IdleHandsProject/youtubeplaybutton/README.md

# youtubeplaybutton
An Arduino YouTube Play Button
