IdleHandsProject/youtubeplaybutton/Outline_Model_150mm_Imported_Details.dxf

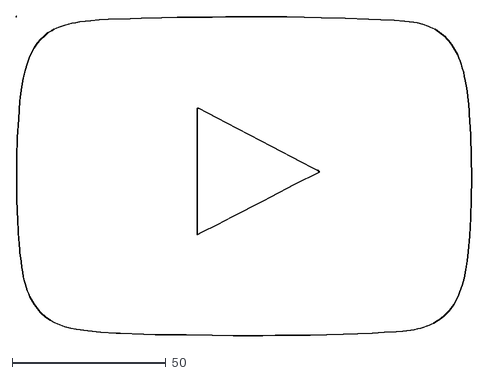
[picture p1: CAD file, 2016-11-22]
Outline_Model_150mm_Imported_Details.dxf
148.2 x 104.1
