IdleHandsProject/youtubeplaybutton/Outline_Model_150mm_Model.dxf

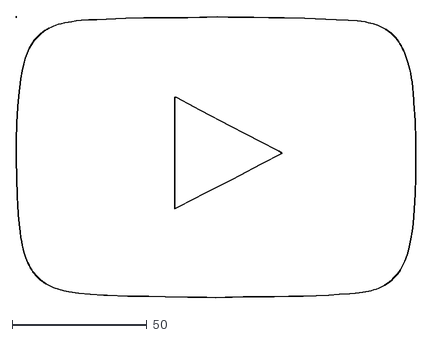
[picture p2: CAD file, 2016-11-22]
Outline_Model_150mm_Model.dxf
148.2 x 104.1
