IdleHandsProject/youtubeplaybutton/Outline_Model.dxf

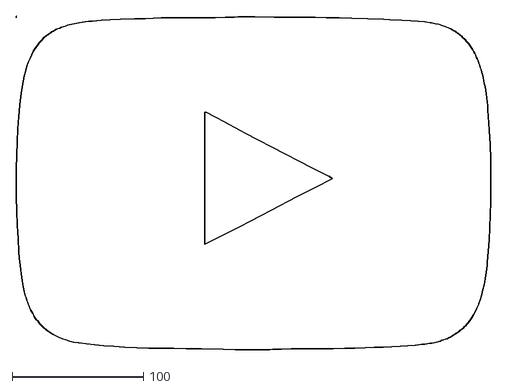
[picture p3: CAD file, 2016-11-22]
Outline_Model.dxf
361.4 x 254.0
