IdleHandsProject/youtubeplaybutton/Outline_Imported_Details.dxf

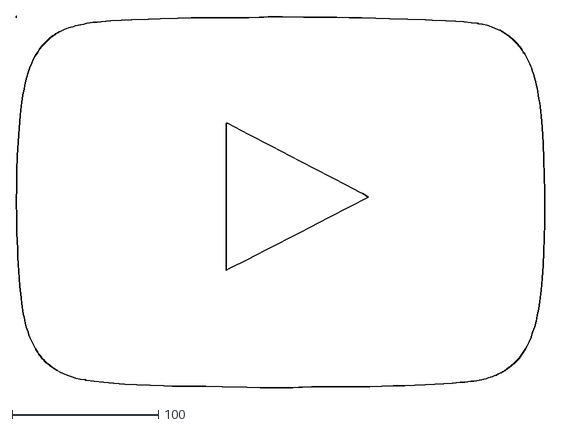
[picture p4: CAD file, 2016-11-22]
Outline_Imported_Details.dxf
361.4 x 254.0
