IdleHandsProject/youtubeplaybutton/playbutton.kicad_pcb

## KiCad design playbutton.kicad_pcb (2016-11-25)

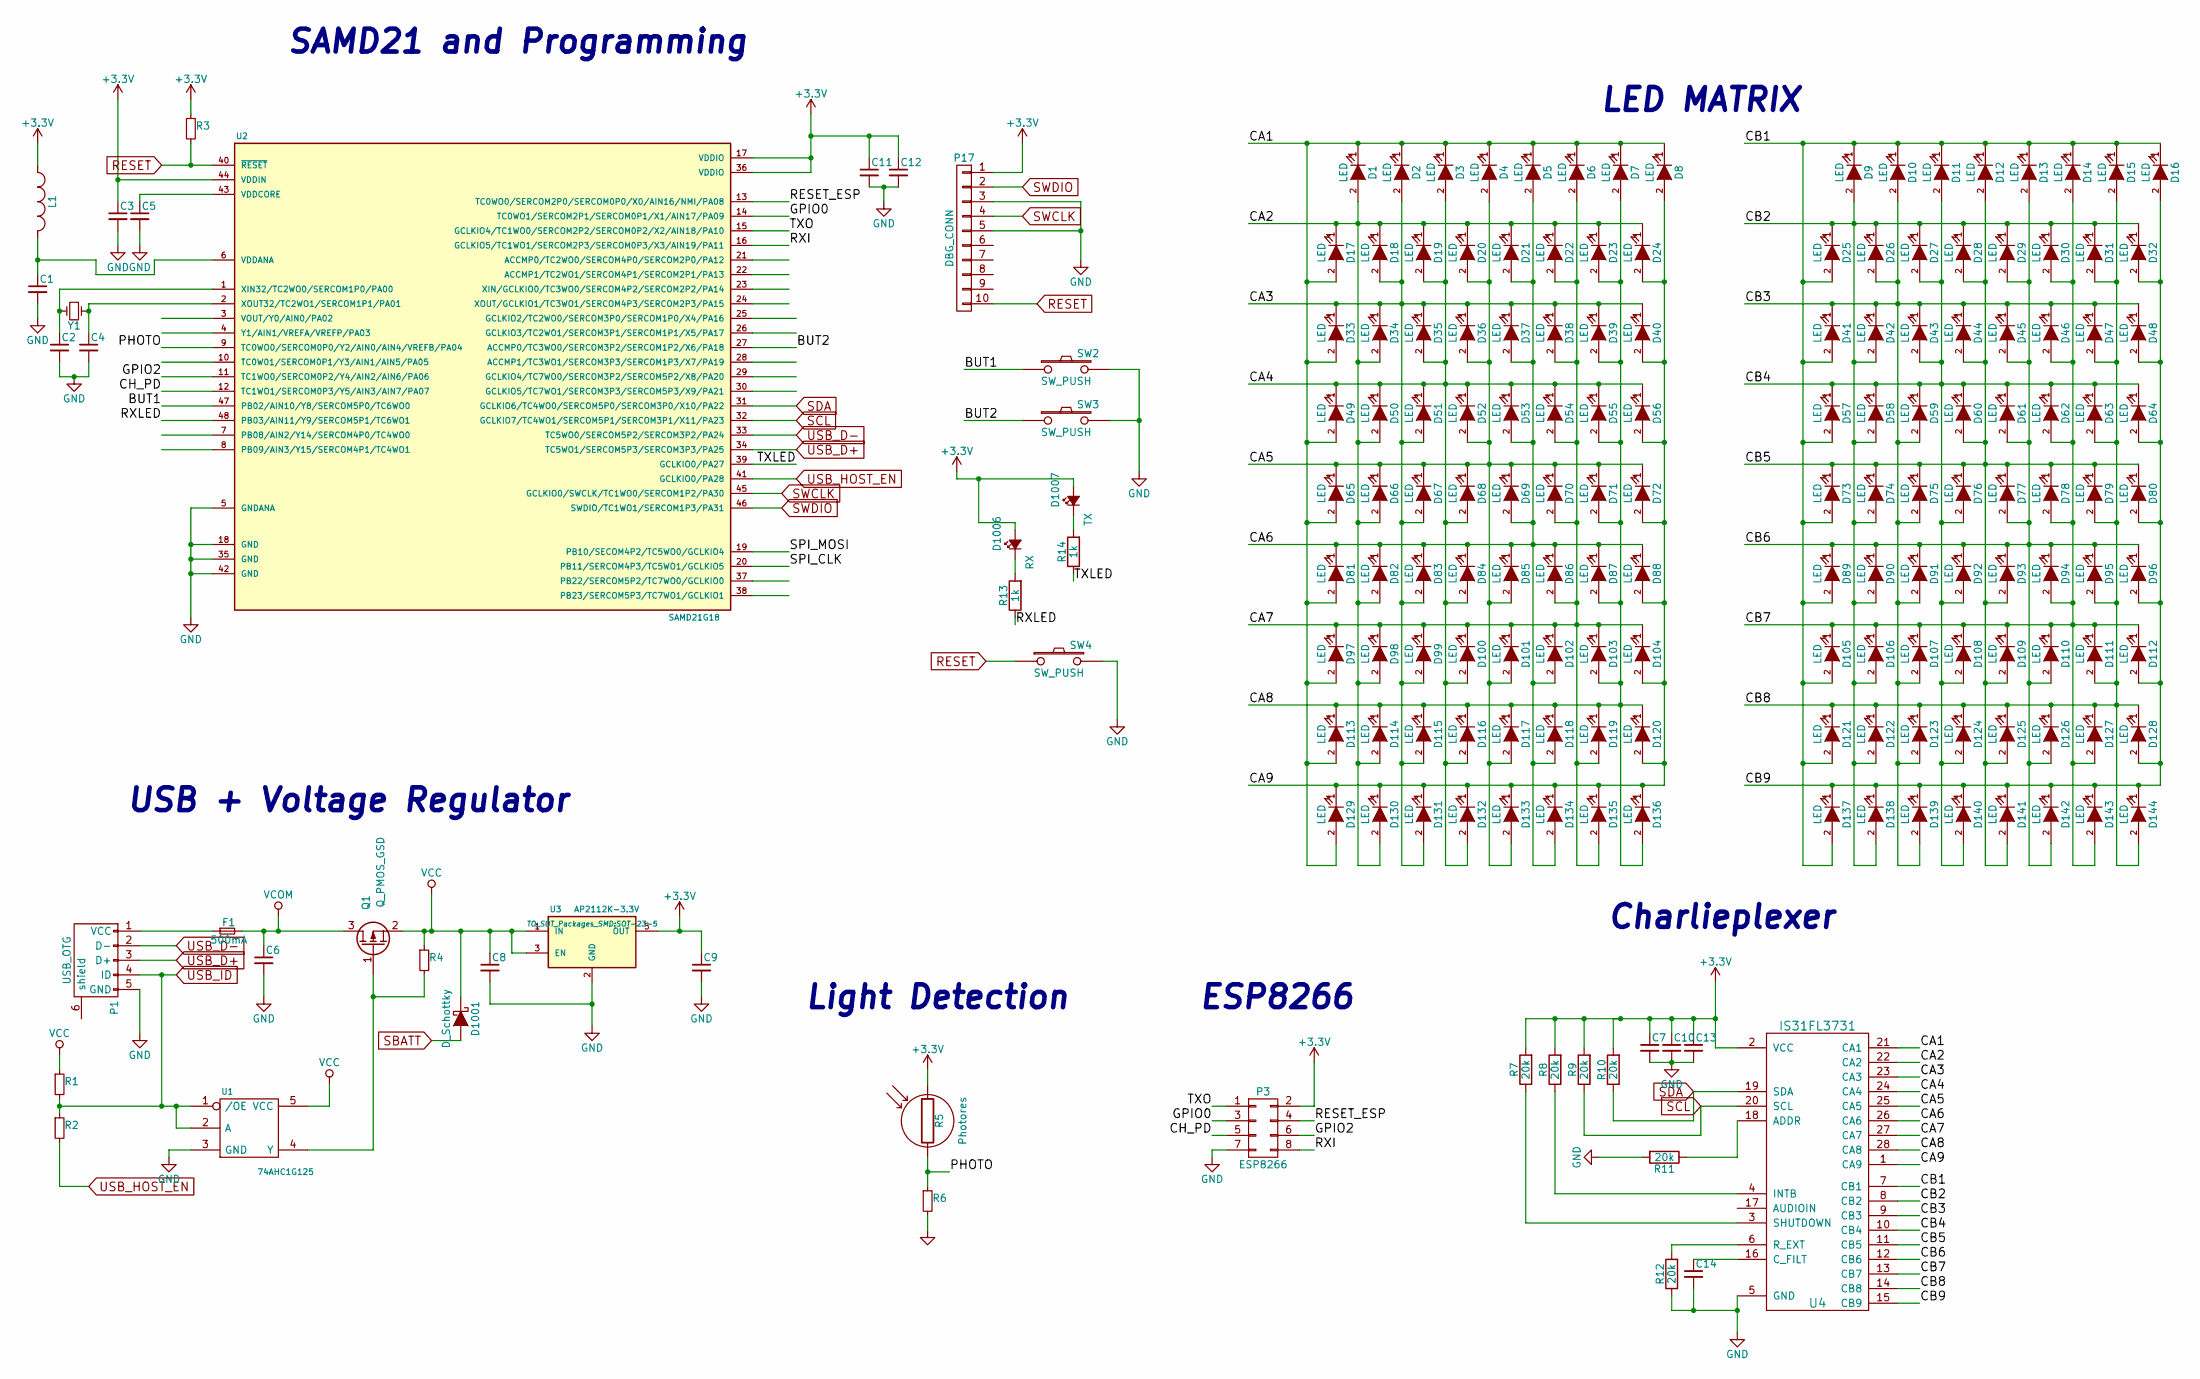
[picture p5: schematic playbutton.sch]

Parts:
C1, C3, C5, C11, C12, C13, C14: 0.1uF; C_0402_Hand; Digikey Part No. 490-6328-1-ND
C2, C4: 15pF; C_0402_Hand; Digikey Part No. 712-1261-1-ND
C6: 2.2uF; c_1206; Digikey Part No. 1276-1291-1-ND
C7, C10: 10uF; C_SM0603; Digikey Part No. 490-6405-1-ND
C8: 1uF; C_0402_Hand; Digikey Part No. 490-4516-1-ND
C9: 2.2uF; C_0402_Hand; Digikey Part No. 587-1059-1-ND
D1, D2, D3, D4, D5, D6, D7, D8, D9, D10, D11, D12, D13, D14, D15, D16, D17, D18, D19, D20, D21, D22, D23, D24, D25, D26, D27, D28, D29, D30, D31, D32, D33, D34, D35, D36, D37, D38, D39, D40, D41, D42, D43, D44, D45, D46, D47, D48, D49, D50, D51, D52, D53, D54, D55, D56, D57, D58, D59, D60, D61, D62, D63, D64, D65, D66, D67, D68, D69, D70, D71, D72, D73, D74, D75, D76, D77, D78, D79, D80, D81, D82, D83, D84, D85, D86, D87, D88, D89, D90, D91, D92, D93, D94, D95, D96, D97, D98, D99, D100, D101, D102, D103, D104, D105, D106, D107, D108, D109, D110, D111, D112, D113, D114, D115, D116, D117, D118, D119, D120, D121, D122, D123, D124, D125, D126, D127, D128, D129, D130, D131, D132, D133, D134, D135, D136, D137, D138, D139, D140, D141, D142, D143, D144: LED; Led_0603
D1001: D_Schottky; sod80c
D1006: RX; Led_0603; Digikey Part No. 160-1447-1-ND
D1007: TX; Led_0603; Digikey Part No. 160-1448-1-ND
F1: 500mA; c_1206; Digikey Part No. 507-1803-1-ND
L1: FB - 30Ohm; R_SM0603; Digikey Part No. 445-2986-1-ND
P1: USB_OTG; USB_Micro-B; Digikey Part No. 609-4618-1-ND
P3: ESP8266; Pin_Header_Straight_2x04
P17: DBG_CONN; Pin_Header_Straight_2x05_Pitch1.27mm; Digikey Part No. 1175-1627-ND
Q1: Q_PMOS_GSD; SOT23
R1: 100k; R_0402_Hand; Digikey Part No. 311-100KLRCT-ND
R2: 330; R_0402_Hand; Digikey Part No. 311-330JRCT-ND
R3, R6: 10k; R_0402_Hand; Digikey Part No. 311-10KJRCT-ND
R4: 47K; R_0402_Hand; Digikey Part No. 311-47.0KLRCT-ND
R5: Photores; Pin_Header_Straight_1x02
R7, R8, R9, R10, R11, R12: 20k; R_0402_Hand; Digikey Part No. 311-20KJRCT-ND
R13, R14: 1k; R_0402_Hand; Digikey Part No. 311-1.0KJRCT-ND
SW2: SW_PUSH; SW_SPST_PTS645; Digikey Part No. CKN9112CT-ND
SW3: SW_PUSH; SW_SPST_PTS645; Digikey Part No. CKN9084CT-ND
SW4: SW_PUSH; SW_SPST_EVQPE1; Digikey Part No. CKN9084CT-ND
U1: 74AHC1G125; sot23-5; Digikey Part No. 568-4452-1-ND
U2: SAMD21G18; TQFP-48_7x7mm_Pitch0.5mm; Digikey Part No. ATSAMD21G18A-AU-ND
U3: AP2112K-3.3V; SOT-23-5; Digikey Part No. AP2112K-3.3TRG1DICT-ND
U4: IS31FL3731; QFN-28-1EP_4x4mm_Pitch0.4mm
Y1: Crystal_Small; crystal_smd_5x3.2mm; Digikey Part No. 535-9536-1-ND

Connections:
+3V3: C3.1, C7.1, C9.1, C10.1, C11.1, C12.1, C13.1, D1006.2 (A), D1007.2 (A), L1.1, P3.2, P17.1, R3.1, R5.1, R7.2, R8.2, R9.2, R10.2, U2.17 (VDDIO), U2.36 (VDDIO), U2.44 (VDDIN), U3.5 (OUT), U4.2 (VCC)
/BUT1: SW2.1, U2.47 (PB02/AIN10/Y8/SERCOM5P0/TC6WO0)
/BUT2: SW3.1, U2.27 (ACCMP0/TC3WO0/SERCOM3P2/SERCOM1P2/X6/PA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)
/CA1: D1.1 (K), D2.1 (K), D3.1 (K), D4.1 (K), D5.1 (K), D6.1 (K), D7.1 (K), D8.1 (K), D17.2 (A), D33.2 (A), D49.2 (A), D65.2 (A), D81.2 (A), D97.2 (A), D113.2 (A), D129.2 (A), U4.21 (CA1)
/CA2: D1.2 (A), D17.1 (K), D18.1 (K), D19.1 (K), D20.1 (K), D21.1 (K), D22.1 (K), D23.1 (K), D24.1 (K), D34.2 (A), D50.2 (A), D66.2 (A), D82.2 (A), D98.2 (A), D114.2 (A), D130.2 (A), U4.22 (CA2)
/CA3: D2.2 (A), D18.2 (A), D33.1 (K), D34.1 (K), D35.1 (K), D36.1 (K), D37.1 (K), D38.1 (K), D39.1 (K), D40.1 (K), D51.2 (A), D67.2 (A), D83.2 (A), D99.2 (A), D115.2 (A), D131.2 (A), U4.23 (CA3)
/CA4: D3.2 (A), D19.2 (A), D35.2 (A), D49.1 (K), D50.1 (K), D51.1 (K), D52.1 (K), D53.1 (K), D54.1 (K), D55.1 (K), D56.1 (K), D68.2 (A), D84.2 (A), D100.2 (A), D116.2 (A), D132.2 (A), U4.24 (CA4)
/CA5: D4.2 (A), D20.2 (A), D36.2 (A), D52.2 (A), D65.1 (K), D66.1 (K), D67.1 (K), D68.1 (K), D69.1 (K), D70.1 (K), D71.1 (K), D72.1 (K), D85.2 (A), D101.2 (A), D117.2 (A), D133.2 (A), U4.25 (CA5)
/CA6: D5.2 (A), D21.2 (A), D37.2 (A), D53.2 (A), D69.2 (A), D81.1 (K), D82.1 (K), D83.1 (K), D84.1 (K), D85.1 (K), D86.1 (K), D87.1 (K), D88.1 (K), D102.2 (A), D118.2 (A), D134.2 (A), U4.26 (CA6)
/CA7: D6.2 (A), D22.2 (A), D38.2 (A), D54.2 (A), D70.2 (A), D86.2 (A), D97.1 (K), D98.1 (K), D99.1 (K), D100.1 (K), D101.1 (K), D102.1 (K), D103.1 (K), D104.1 (K), D119.2 (A), D135.2 (A), U4.27 (CA7)
/CA8: D7.2 (A), D23.2 (A), D39.2 (A), D55.2 (A), D71.2 (A), D87.2 (A), D103.2 (A), D113.1 (K), D114.1 (K), D115.1 (K), D116.1 (K), D117.1 (K), D118.1 (K), D119.1 (K), D120.1 (K), D136.2 (A), U4.28 (CA8)
/CA9: D8.2 (A), D24.2 (A), D40.2 (A), D56.2 (A), D72.2 (A), D88.2 (A), D104.2 (A), D120.2 (A), D129.1 (K), D130.1 (K), D131.1 (K), D132.1 (K), D133.1 (K), D134.1 (K), D135.1 (K), D136.1 (K), U4.1 (CA9)
/CB1: D9.1 (K), D10.1 (K), D11.1 (K), D12.1 (K), D13.1 (K), D14.1 (K), D15.1 (K), D16.1 (K), D25.2 (A), D41.2 (A), D57.2 (A), D73.2 (A), D89.2 (A), D105.2 (A), D121.2 (A), D137.2 (A), U4.7 (CB1)
/CB2: D9.2 (A), D25.1 (K), D26.1 (K), D27.1 (K), D28.1 (K), D29.1 (K), D30.1 (K), D31.1 (K), D32.1 (K), D42.2 (A), D58.2 (A), D74.2 (A), D90.2 (A), D106.2 (A), D122.2 (A), D138.2 (A), U4.8 (CB2)
/CB3: D10.2 (A), D26.2 (A), D41.1 (K), D42.1 (K), D43.1 (K), D44.1 (K), D45.1 (K), D46.1 (K), D47.1 (K), D48.1 (K), D59.2 (A), D75.2 (A), D91.2 (A), D107.2 (A), D123.2 (A), D139.2 (A), U4.9 (CB3)
/CB4: D11.2 (A), D27.2 (A), D43.2 (A), D57.1 (K), D58.1 (K), D59.1 (K), D60.1 (K), D61.1 (K), D62.1 (K), D63.1 (K), D64.1 (K), D76.2 (A), D92.2 (A), D108.2 (A), D124.2 (A), D140.2 (A), U4.10 (CB4)
/CB5: D12.2 (A), D28.2 (A), D44.2 (A), D60.2 (A), D73.1 (K), D74.1 (K), D75.1 (K), D76.1 (K), D77.1 (K), D78.1 (K), D79.1 (K), D80.1 (K), D93.2 (A), D109.2 (A), D125.2 (A), D141.2 (A), U4.11 (CB5)
/CB6: D13.2 (A), D29.2 (A), D45.2 (A), D61.2 (A), D77.2 (A), D89.1 (K), D90.1 (K), D91.1 (K), D92.1 (K), D93.1 (K), D94.1 (K), D95.1 (K), D96.1 (K), D110.2 (A), D126.2 (A), D142.2 (A), U4.12 (CB6)
/CB7: D14.2 (A), D30.2 (A), D46.2 (A), D62.2 (A), D78.2 (A), D94.2 (A), D105.1 (K), D106.1 (K), D107.1 (K), D108.1 (K), D109.1 (K), D110.1 (K), D111.1 (K), D112.1 (K), D127.2 (A), D143.2 (A), U4.13 (CB7)
/CB8: D15.2 (A), D31.2 (A), D47.2 (A), D63.2 (A), D79.2 (A), D95.2 (A), D111.2 (A), D121.1 (K), D122.1 (K), D123.1 (K), D124.1 (K), D125.1 (K), D126.1 (K), D127.1 (K), D128.1 (K), D144.2 (A), U4.14 (CB8)
/CB9: D16.2 (A), D32.2 (A), D48.2 (A), D64.2 (A), D80.2 (A), D96.2 (A), D112.2 (A), D128.2 (A), D137.1 (K), D138.1 (K), D139.1 (K), D140.1 (K), D141.1 (K), D142.1 (K), D143.1 (K), D144.1 (K), U4.15 (CB9)
/CH_PD: P3.5, U2.12 (TC1WO1/SERCOM0P3/Y5/AIN3/AIN7/PA07)
/GPIO0: P3.3, U2.14 (TC0WO1/SERCOM2P1/SERCOM0P1/X1/AIN17/PA09)
/GPIO2: P3.6, U2.11 (TC1WO0/SERCOM0P2/Y4/AIN2/AIN6/PA06)
/PHOTO: R5.2, R6.1, U2.9 (TC0WO0/SERCOM0P0/Y2/AIN0/AIN4/VREFB/PA04)
/RESET_ESP: P3.4, U2.13 (TC0WO0/SERCOM2P0/SERCOM0P0/X0/AIN16/NMI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)
/RXI: P3.8, U2.16 (GCLKIO5/TC1WO1/SERCOM2P3/SERCOM0P3/X3/A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)
/RXLED: R13.1, U2.48 (PB03/AIN11/Y9/SERCOM5P1/TC6WO1)
/SPI_CLK: U2.20 (PB11/SERCOM4P3/TC5WO1/GCLKIO5)
/SPI_MOSI: U2.19 (PB10/SECOM4P2/TC5WO0/GCLKIO4)
/TXLED: R14.1, U2.39 (GCLKIO0/PA27)
/TXO: P3.1, U2.15 (GCLKIO4/TC1WO0/SERCOM2P2/SERCOM0P2/X2/A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)
GND: C1.2, C2.2, C3.2, C4.2, C5.2, C6.2, C7.2, C8.2, C9.2, C10.2, C11.2, C12.2, C13.2, C14.2, P1.5 (GND), P3.7, P17.3, P17.5, R6.2, R11.2, R12.1, SW2.2, SW3.2, SW4.2, U1.3 (GND), U2.5 (GNDANA), U2.18 (GND), U2.35 (GND), U2.42 (GND), U3.2 (GND), U4.5 (GND)
unnamed: C1.1, L1.2, U2.6 (VDDANA)
unnamed: C2.1, U2.1 (XIN32/TC2WO0/SERCOM1P0/PA00), Y1.2
unnamed: C4.1, U2.2 (XOUT32/TC2WO1/SERCOM1P1/PA01), Y1.1
unnamed: C5.1, U2.43 (VDDCORE)
unnamed: C14.1, U4.16 (C_FILT)
unnamed: D1006.1 (K), R13.2
unnamed: D1007.1 (K), R14.2
unnamed: F1.1, P1.1 (VCC)
unnamed: Q1.1 (G), R4.2, U1.4 (Y)
unnamed: R7.1, U4.3 (SHUTDOWN)
unnamed: R8.1, U4.4 (INTB)
unnamed: R11.1, U4.18 (ADDR)
unnamed: R12.2, U4.6 (R_EXT)
RESET: P17.10, R3.2, SW4.1, U2.40 (~RESET~)
SCL: R9.1, U2.32 (GCLKIO7/TC4WO1/SERCOM5P1/SERCOM3P1/X11/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), U4.20 (SCL)
SDA: R10.1, U2.31 (GCLKIO6/TC4WO0/SERCOM5P0/SERCOM3P0/X10/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), U4.19 (SDA)
SWCLK: P17.4, U2.45 (GCLKIO0/SWCLK/TC1WO0/SERCOM1P2/PA30)
SWDIO: P17.2, U2.46 (SWDIO/TC1WO1/SERCOM1P3/PA31)
USB_D+: P1.3 (D+), U2.34 (TC5WO1/SERCOM5P3/SERCOM3P3/PA25)
USB_D-: P1.2 (D-), U2.33 (TC5WO0/SERCOM5P2/SERCOM3P2/PA24)
USB_HOST_EN: R2.2, U2.41 (GCLKIO0/PA28)
USB_ID: P1.4 (ID), R1.2, R2.1, U1.1 (/OE), U1.2 (A)
VCC: C8.1, D1001.1 (K), Q1.2 (S), R1.1, R4.1, U1.5 (VCC), U3.1 (IN), U3.3 (EN)
VCOM: C6.1, F1.2, Q1.3 (D)

Notes on the sheet:
USB + Voltage Regulator
LED MATRIX
ESP8266
Charlieplexer
Light Detection
SAMD21 and Programming

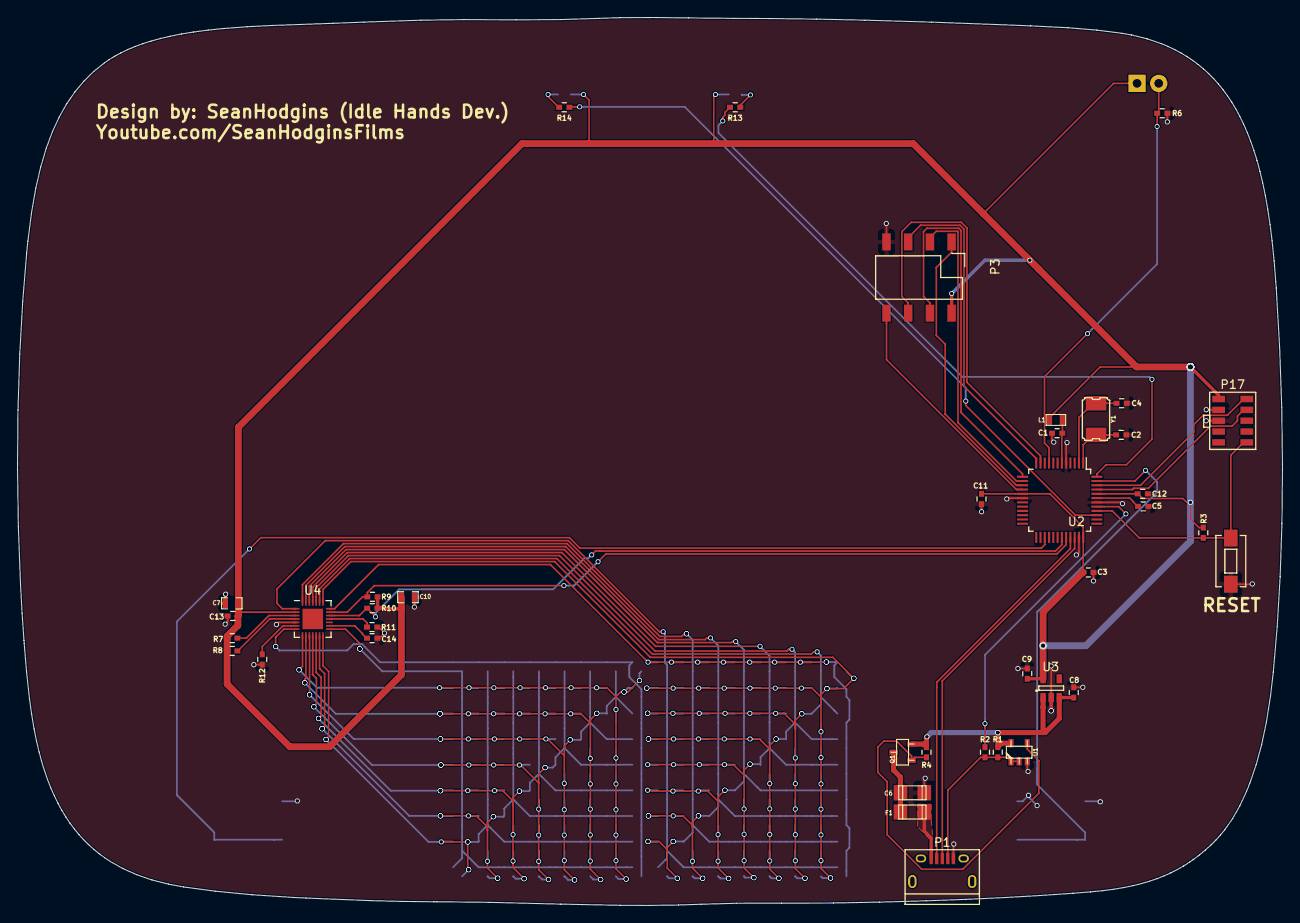
[picture p6: board playbutton.kicad_pcb from above]

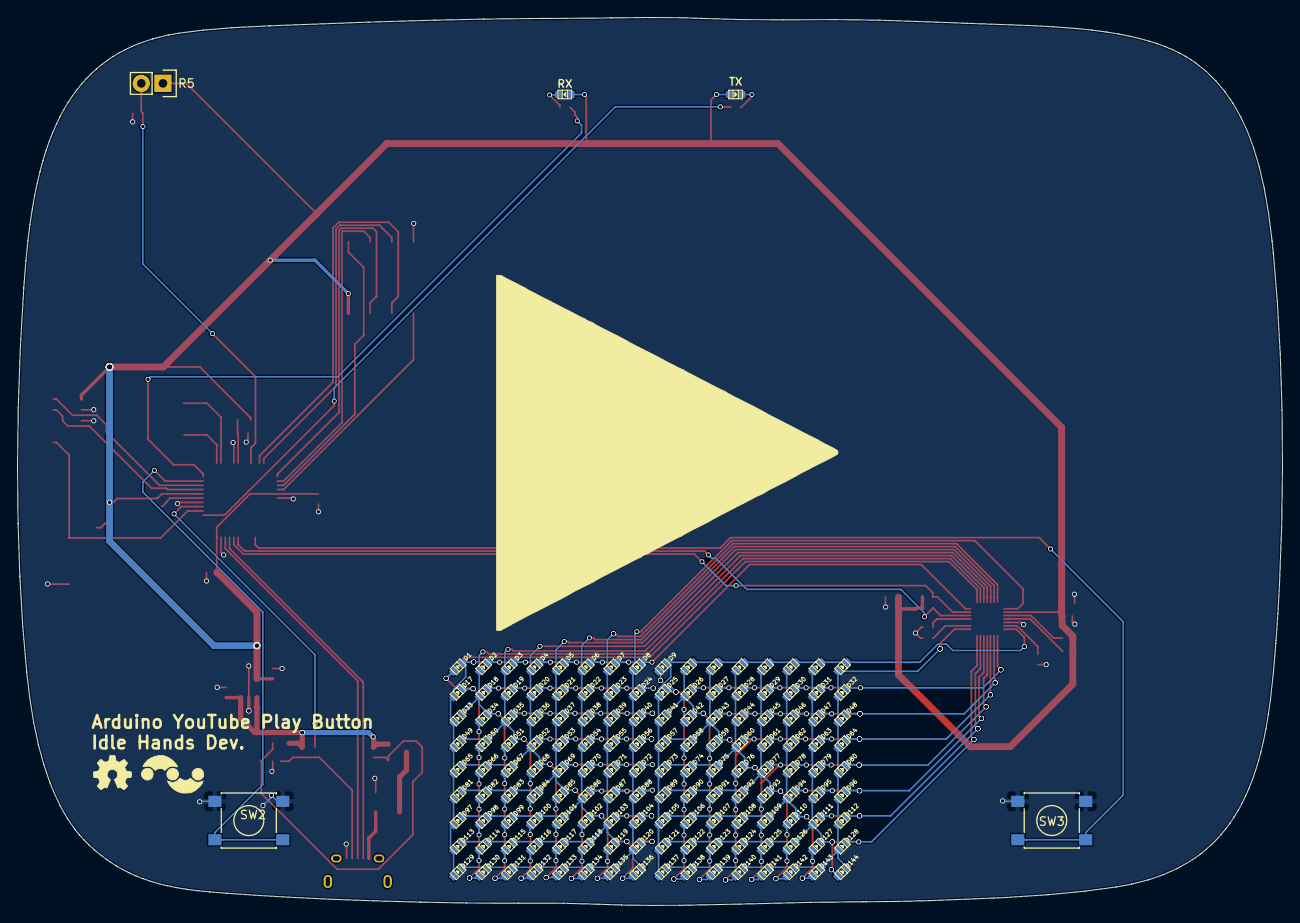
[picture p7: board playbutton.kicad_pcb from below]

Board: 2 copper layers, 148.1 x 103.9 mm, 188 parts (149 on the bottom side), 55 nets.
