IdleHandsProject/youtubeplaybutton/(threads)

Thread 1 (2016-11-22):

LED 35 and 51 switched?

hodginsa, 2016-11-22:
LED 35 and 51 seem to be switched, if you tell LED 35 to turn on, 51 turns on, and vice versa. I can't seem to find any errors in the schematic or the PCB. Help?

Further note, the second set of LEDs in the schem were just a copy and paste of the first set, therefore the issue should be duplicated, but it is not. Weird issue. However, not major.

hodginsa, 2016-11-23:
Well... I figured it out. **No issue with the board.** I somehow managed to put two LEDs, one after the other, in the reverse direction. This made them turn on opposite of each other. Had only one been switched they both would have lit up. At least it was only 2 out of 144.

Can you find them?
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

Closed 2016-11-23.
