IdleHandsProject/youtubeplaybutton/(commit log)

2016-11-22 Files Removed
    [BOM.csv]
2016-11-25 Added digikey part(s) No.
    [Bom_Digikey.csv, _saved_playbutton.sch, bom_Digikey.csv, playbutton.kicad_pcb]
2016-11-25 Firmware Added
    [playbutton.sch]
